jan-hofmeier/mlc2sd/(commit log)

2023-12-21 initial push
    [WiiU-SD-Interposer.kicad_pcb, WiiU-SD-Interposer.kicad_sch]
2023-12-21 move traces around
    [WiiU-SD-Interposer.kicad_pcb]
2023-12-21 move measurements to right layer
    [WiiU-SD-Interposer.kicad_pcb]
2023-12-21 add text to backside
    [WiiU-SD-Interposer.kicad_pcb]
2023-12-22 move vias out of the pads
    [WiiU-SD-Interposer.kicad_pcb]
2024-01-06 change notch for half circle
    [WiiU-SD-Interposer.kicad_pcb]
2024-01-12 Add Revison to silkscreen
    [WiiU-SD-Interposer.kicad_pcb]
2024-02-11 move GND via
    [WiiU-SD-Interposer.kicad_pcb]
2024-02-11 update revision
    [WiiU-SD-Interposer.kicad_pcb]
2024-03-16 add note and change shape
    [WiiU-SD-Interposer.kicad_pcb]
2024-03-16 bump Rev
    [WiiU-SD-Interposer.kicad_pcb]
2024-03-23 update gbatempt link
    [WiiU-SD-Interposer.kicad_pcb]
2024-03-23 drill inner corner
    [WiiU-SD-Interposer.kicad_pcb]
2024-10-17 move trace
    [WiiU-SD-Interposer.kicad_pcb]
2024-10-17 remove measurement
    [WiiU-SD-Interposer.kicad_pcb]
